MordeKyle/NixieTubeClockATMEGA328P/Parts List.txt

Parts list:
**ATMEGA328P-PU** - https://www.digikey.com/en/products/detail/microchip-technology/ATMEGA328P-PU/1914589
**2032 Battery Holder** - https://www.amazon.com/dp/B0BJ1J4WY1?psc=1&ref=ppx_yo2ov_dt_b_product_details
**2032 Battery** - https://www.digikey.com/en/products/detail/ecs-inc/ECS-.327-12.5-13X/827615
**32.7680KHZ Cyrstal** - https://www.digikey.com/en/products/detail/ecs-inc/ECS-.327-12.5-13X/827615
DS1307 RTC - https://www.ebay.com/itm/224302451696
DIP IC Socket Adapter Kit - https://www.ebay.com/itm/224043518271
LM7805 Voltage Regulator - https://www.ebay.com/itm/381374640824
4x 100nF and 2x 10uF Capacitors -  https://www.ebay.com/itm/292963354070
1kΩ resistors - https://www.ebay.com/itm/324083572997
**2.2kΩ 1206 Resistors** https://www.digikey.com/en/products/detail/te-connectivity-passive-product/CRGH1206F2K2/7494998
**10kΩ 1206 Resistors** https://www.digikey.com/en/products/detail/te-connectivity-passive-product/CRGH1206F10K/2387463
**107kΩ 1206 Resistors** https://www.digikey.com/en/products/detail/bourns-inc/CR1206-FX-1073ELF/2562693
**PJ-202A Barrel Power Jack** https://www.digikey.com/en/products/detail/cui-devices/PJ-202A/252007
**IN-12A Nixie Tubes** https://www.ebay.com/itm/354593635922
K155ID1 Nixie Tube Drivers - https://www.ebay.com/itm/332788800592
**16MHz Crystal and 20pF Capacitors** - https://www.adafruit.com/product/2215
12v Wall Adapter - https://www.amazon.com/TMEZON-Power-Adapter-Supply-2-1mm/dp/B00Q2E5IXW
**NCH8200HV Nixie DC-DC High Voltage Boost Power Converter** https://omnixie.com/products/nch8200hv-nixie-hv-power-module
**Dual row 90 degree male headers** https://www.amazon.com/dp/B00REGUVCA?ref=ppx_yo2ov_dt_b_product_details&th=1
**Pin Jumpers** https://www.amazon.com/dp/B0BRK334XH?ref=ppx_yo2ov_dt_b_product_details&th=1
**NE-2 Neon Bulb** https://www.amazon.com/dp/B06WV8XJ6G?psc=1&ref=ppx_yo2ov_dt_b_product_details

You will also need a working Arduino and maybe some sort of FTDI to send code to the ATMEGA328P - https://www.sparkfun.com/products/9716

** items indicate items I purchased for this project and are know to work. The rest of the items I either already had or purchased from different vendors.
