MordeKyle/NixieTubeClockATMEGA328P/(commit log)

2021-08-24 Building Robin
    Building the code and fixing parts list.
    [NixieTubeClockATMEGA328P.ino]
2021-09-14 Release Robin
    Fully working with adjustments to errors in Nixie pinout.
    [NixieTubeClockATMEGA328P.ino]
2023-12-13 Update NixieTubeClockATMEGA328P.ino
    Minor fixes to tube constants
    [NixieTubeClockATMEGA328P.ino]
2023-12-14 Version 0.9
    Code is mostly untested. Waiting for circuit boards to arrive.
2023-12-20 Version 0.9.2
    New button setup
